aswin385-s/robotic-parallel-jaw-gripper-design/simulation_results/Simulation_Studies_Report.html

- Header
- Report Properties
- Simulation Model 1
  - Study 1 - Static Stress
    - Study Properties
    - Study Setup
      - Settings
      - Materials
      - Contacts
      - Mesh
      - Load Case1
        - Constraints
        - Loads
        - Guided Results
          - Safety Factor
        - Results
          - Safety Factor
          - Stress
          - Displacement

Study Report

Analyzed File | stress study | Version | Autodesk Fusion (2705.1.15)
Creation Date | 2026-09-25, 13:35:44 | Author | Aswin S Pillai

Report Properties

Report Properties
Title | Studies
Author | Aswin S Pillai

Simulation Model 1

Study 1 - Static Stress

Study Properties

Study Properties
Study Type | Static Stress
Last Modification Date | 2026-09-25, 12:35:28

Study Setup

Settings
General

Contact Tolerance | 0.10 mm
Remove Rigid Body Modes | No
Mesh

Average Element Size (% of model size) - Solids | 10
Scale Mesh Size Per Part | No
Average Element Size (absolute value) | -
Element Order | Parabolic
Create Curved Mesh Elements | No
Max. Turn Angle on Curves (Deg.) | 60
Max. Adjacent Mesh Size Ratio | 1.5
Max. Aspect Ratio | 10
Minimum Element Size (% of average size) | 20
Adaptive Mesh Refinement

Number of Refinement Steps | 0
Results Convergence Tolerance (%) | 20
Portion of Elements to Refine (%) | 10
Results for Baseline Accuracy | von Mises Stress

Materials
Aluminum
Components

Component | Strength
screws:1/hex_socket_cylindrical_head_M4x20(Mirror):1 | Yield Strength
screws:1/hex_socket_cylindrical_head_M4x20:1 | Yield Strength
screws:1/hex_socket_cylindrical_head_M5x08:1 | Yield Strength
screws:1/hex_socket_cylindrical_head_M5x08:2 | Yield Strength
screws:1/hex_socket_cylindrical_head_M5x08:3 | Yield Strength
screws:1/hex_socket_cylindrical_head_M5x08:4 | Yield Strength
Properties

Density | 2.700E-06 kg / mm^3
Young's Modulus | 68900.00 MPa
Poisson's Ratio | 0.33
Yield Strength | 275.00 MPa
Ultimate Tensile Strength | 310.00 MPa
Thermal Conductivity | 0.23 W / (mm K)
Thermal Expansion Coefficient | 2.360E-05 / K
Specific Heat | 897.00 J / (kg K)
Steel
Components

Component | Strength
coupler:1 | Yield Strength
pinion:1 | Yield Strength
rod 2:1 | Yield Strength
rod:1 | Yield Strength
Properties

Density | 7.850E-06 kg / mm^3
Young's Modulus | 210000.00 MPa
Poisson's Ratio | 0.30
Yield Strength | 207.00 MPa
Ultimate Tensile Strength | 345.00 MPa
Thermal Conductivity | 0.056 W / (mm K)
Thermal Expansion Coefficient | 1.200E-05 / K
Specific Heat | 480.00 J / (kg K)
Rubber, Butyl
Components

Component | Strength
jaw_pad (1):1 | Yield Strength
jaw_pad:1 | Yield Strength
Properties

Density | 1.200E-07 kg / mm^3
Young's Modulus | 2.00 MPa
Poisson's Ratio | 0.49
Yield Strength | 15.00 MPa
Ultimate Tensile Strength | 15.00 MPa
Thermal Conductivity | 8.800E-05 W / (mm K)
Thermal Expansion Coefficient | 1.300E-04 / K
Specific Heat | 1966.00 J / (kg K)
Aluminum 6061 T6 0 Cold Formed
Components

Component | Strength
arm_connection:1 | Yield Strength
gripper_base:1 | Yield Strength
jaw1:1 | Yield Strength
jaw2:1 | Yield Strength
pinion_holder:1 | Yield Strength
Properties

Density | 2.700E-06 kg / mm^3
Young's Modulus | 69000.00 MPa
Poisson's Ratio | 0.33
Yield Strength | 369.00 MPa
Ultimate Tensile Strength | 389.00 MPa
Thermal Conductivity | 0.18 W / (mm K)
Thermal Expansion Coefficient | 2.360E-05 / K
Specific Heat | 896.00 J / (kg K)

Contacts
Contact Type | Contact Set | Penetration Type | Bodies | Entities
Bonded

[M] Bonded8 | Symmetric | [Body1 rod:1||Body2 gripper_base:1] | [Face 22||Face 2185]
[M] Bonded9 | Symmetric | [Body1 rod:1||Body2 gripper_base:1] | [Face 22||Face 2184]
[M] Bonded10 | Symmetric | [Body1 rod 2:1||Body2 gripper_base:1] | [Face 22||Face 2180]
[M] Bonded11 | Symmetric | [Body1 rod 2:1||Body2 gripper_base:1] | [Face 22||Face 2181]
[M] Bonded12 | Symmetric | [Body1 pinion:1||Body1 coupler:1] | [Face 2772||Face 1855]
Bonded13 | Symmetric | [Body2 gripper_base:1||Body1 hex_socket_cylindrical_head_M4x20(Mirror):1] | [Face 2197||Face 157]
Bonded14 | Symmetric | [Body2 gripper_base:1||Body1 hex_socket_cylindrical_head_M4x20:1] | [Face 2197||Face 157]
Bonded15 | Symmetric | [Body2 gripper_base:1||Body1 rod:1] | [Face 2187||Face 24]
Bonded16 | Symmetric | [Body2 gripper_base:1||Body1 rod:1] | [Face 2186||Face 23]
Bonded17 | Symmetric | [Body2 gripper_base:1||Body1 rod 2:1] | [Face 2183||Face 24]
Bonded18 | Symmetric | [Body2 gripper_base:1||Body1 rod 2:1] | [Face 2182||Face 23]
Bonded19 | Symmetric | [Body2 gripper_base:1||Body1 hex_socket_cylindrical_head_M4x20(Mirror):1] | [Face 2156||Face 156]
Bonded20 | Symmetric | [Body2 gripper_base:1||Body1 hex_socket_cylindrical_head_M4x20(Mirror):1] | [Face 2154||Face 156]
Bonded21 | Symmetric | [Body2 gripper_base:1||Body1 hex_socket_cylindrical_head_M4x20:1] | [Face 2153||Face 156]
Bonded22 | Symmetric | [Body2 gripper_base:1||Body1 hex_socket_cylindrical_head_M4x20:1] | [Face 2151||Face 156]
Bonded23 | Symmetric | [Body2 gripper_base:1||Body1 hex_socket_cylindrical_head_M5x08:4] | [Face 2071||Face 156]
Bonded24 | Symmetric | [Body2 gripper_base:1||Body1 hex_socket_cylindrical_head_M5x08:1] | [Face 2067||Face 156]
Bonded25 | Symmetric | [Body2 gripper_base:1||Body1 hex_socket_cylindrical_head_M5x08:3] | [Face 2069||Face 156]
Bonded26 | Symmetric | [Body2 gripper_base:1||Body1 hex_socket_cylindrical_head_M5x08:2] | [Face 2065||Face 156]
Bonded28 | Symmetric | [Body1 pinion_holder:1||Body1 hex_socket_cylindrical_head_M4x20:1] | [Face 138||Face 156]
Bonded29 | Symmetric | [Body1 pinion_holder:1||Body2 gripper_base:1] | [Face 137||Face 2190]
Bonded30 | Symmetric | [Body1 pinion_holder:1||Body2 gripper_base:1] | [Face 137||Face 2160]
Bonded31 | Symmetric | [Body1 pinion_holder:1||Body2 gripper_base:1] | [Face 136||Face 2189]
Bonded32 | Symmetric | [Body1 pinion_holder:1||Body2 gripper_base:1] | [Face 136||Face 2188]
Bonded33 | Symmetric | [Body1 pinion_holder:1||Body2 gripper_base:1] | [Face 135||Face 2191]
Bonded34 | Symmetric | [Body1 pinion_holder:1||Body2 gripper_base:1] | [Face 135||Face 2162]
Bonded35 | Symmetric | [Body1 pinion_holder:1||Body2 gripper_base:1] | [Face 134||Face 2161]
Bonded36 | Symmetric | [Body1 pinion_holder:1||Body2 gripper_base:1] | [Face 134||Face 2159]
Bonded37 | Symmetric | [Body1 pinion_holder:1||Body1 hex_socket_cylindrical_head_M4x20(Mirror):1] | [Face 131||Face 156]
Bonded38 | Symmetric | [Body1 jaw2:1||Body2 gripper_base:1] | [Face 2099||Face 2196]
Bonded39 | Symmetric | [Body1 jaw2:1||Body1 jaw_pad (1):1] | [Face 2097||Face 385]
Bonded40 | Symmetric | [Body1 jaw2:1||Body1 hex_socket_cylindrical_head_M4x20:1] | [Face 2090||Face 158]
Bonded41 | Symmetric | [Body1 jaw2:1||Body1 pinion_holder:1] | [Face 2089||Face 134]
Bonded42 | Symmetric | [Body1 jaw2:1||Body1 pinion_holder:1] | [Face 2088||Face 135]
Bonded43 | Symmetric | [Body1 jaw1:1||Body2 gripper_base:1] | [Face 2085||Face 2196]
Bonded44 | Symmetric | [Body1 jaw1:1||Body1 jaw_pad:1] | [Face 2079||Face 368]
Bonded45 | Symmetric | [Body1 jaw1:1||Body1 pinion_holder:1] | [Face 2077||Face 137]
Bonded46 | Symmetric | [Body1 jaw1:1||Body1 pinion_holder:1] | [Face 2076||Face 134]
Bonded47 | Symmetric | [Body1 pinion:1||Body1 coupler:1] | [Face 2916||Face 1847]
Bonded48 | Symmetric | [Body1 pinion:1||Body1 pinion_holder:1] | [Face 2768||Face 130]
[M] Bonded49 | Symmetric | [Body2 gripper_base:1||Body4 arm_connection:1] | [Face 2062||Face 494]
Bonded50 | Symmetric | [Body4 arm_connection:1||Body1 hex_socket_cylindrical_head_M5x08:2] | [Face 521||Face 157]
Bonded51 | Symmetric | [Body4 arm_connection:1||Body1 hex_socket_cylindrical_head_M5x08:4] | [Face 492||Face 156]
Bonded52 | Symmetric | [Body4 arm_connection:1||Body1 hex_socket_cylindrical_head_M5x08:3] | [Face 491||Face 156]
Bonded53 | Symmetric | [Body4 arm_connection:1||Body1 hex_socket_cylindrical_head_M5x08:1] | [Face 490||Face 156]
Bonded54 | Symmetric | [Body4 arm_connection:1||Body1 hex_socket_cylindrical_head_M5x08:2] | [Face 489||Face 156]
Sliding

[M] Sliding4 | Symmetric | [Body1 jaw1:1||Body1 rod:1] | [Face 2075||Face 22]
[M] Sliding5 | Symmetric | [Body1 jaw1:1||Body1 rod 2:1] | [Face 2074||Face 22]
[M] Sliding6 | Symmetric | [Body1 jaw2:1||Body1 rod 2:1] | [Face 2086||Face 22]
[M] Sliding7 | Symmetric | [Body1 jaw2:1||Body1 rod:1] | [Face 2087||Face 22]
Separation

[M] Separation2 | Symmetric | [Body1 pinion:1||Body1 jaw2:1] | [Face 2912||Face 2137]
[M] Separation3 | Symmetric | [Body1 pinion:1||Body1 jaw1:1] | [Face 2882||Face 2165]

Mesh
Type | Solids
Nodes | 526544
Elements | 332937

Load Case1

Constraints
Fixed3

Type | Fixed
Ux | Fixed
Uy | Fixed
Uz | Fixed

Loads
Gravity

Type | Gravity
Magnitude | 9.807 m / s^2
X Value | 0.00 m / s^2
Y Value | 0.00 m / s^2
Z Value | -9.807 m / s^2
Force1

Type | Force
Magnitude | 120.00 N
X Value | -120.00 N
Y Value | 0.00 N
Z Value | 0.00 N
Flip Direction | Yes
Force Per Entity | No
Force2

Type | Force
Magnitude | 120.00 N
X Value | 120.00 N
Y Value | 0.00 N
Z Value | 0.00 N
Flip Direction | Yes
Force Per Entity | No

Load Case1 - Guided Results

Safety Factor

With the analysis criteria in this study setup, the design is expected to bend permanently or break.

Next Steps

Below Safety Factor Target

Validate your study setup

Check the loads are not set too high

Check the mesh refinement and consider increasing it in areas of high stress

Confirm your Safety Factor requirement

If the Displacement result shows high displacement, consider running a Nonlinear study to gain more insight

Check other results

Examine the Below target Result visualization to see where the weakest areas are

Check the stress result to see if, and where, the material might yield

Check the displacement result to see how far from its original alignment the model has moved

Look at other results, such as reaction forces to check your study set up, or strain to check your material performance

Strengthen weak areas

Add more material to weak areas

Select a material with a higher yield strength

Stiffen the design

Modify the shape with a Generative Design study

Generate alternative designs

Add more material to weak areas

Select a material with a higher yield strength

Stiffen the design

Modify the shape with a Generative Design study

Above Safety Factor Limit

Validate your study setup

Check the loads are not set too high

Check the mesh refinement and consider increasing it in areas of high stress

Confirm your Safety Factor requirement

If the Displacement result shows high displacement, consider running a Nonlinear study to gain more insight

Check other results

Examine the Below target Result visualization to see where the weakest areas are

Check the stress result to see if, and where, the material might yield

Check the displacement result to see how far from its original alignment the model has moved

Look at other results, such as reaction forces to check your study set up, or strain to check your material performance

Lightweight the design

Set a Safety Factor upper limit to find where material can be removed

Remove material from areas that exceed the Safety Factor upper limit

Generate alternative designs

In the Generative Design workspace, create design modifications

Remove unnecessary material using a Shape Optimization study

Load Case1 - Results

Result Summary
Result type | Sub-result | Minimum | Maximum

Safety Factor

Safety Factor

Stress

Von Mises

$$ImageCompatibilityInfo$

1st Principal

$$ImageCompatibilityInfo$

3rd Principal

$$ImageCompatibilityInfo$

Displacement

Total
