aswin385-s/robotic-parallel-jaw-gripper-design/cad_files/complete_gripper_assembly.step

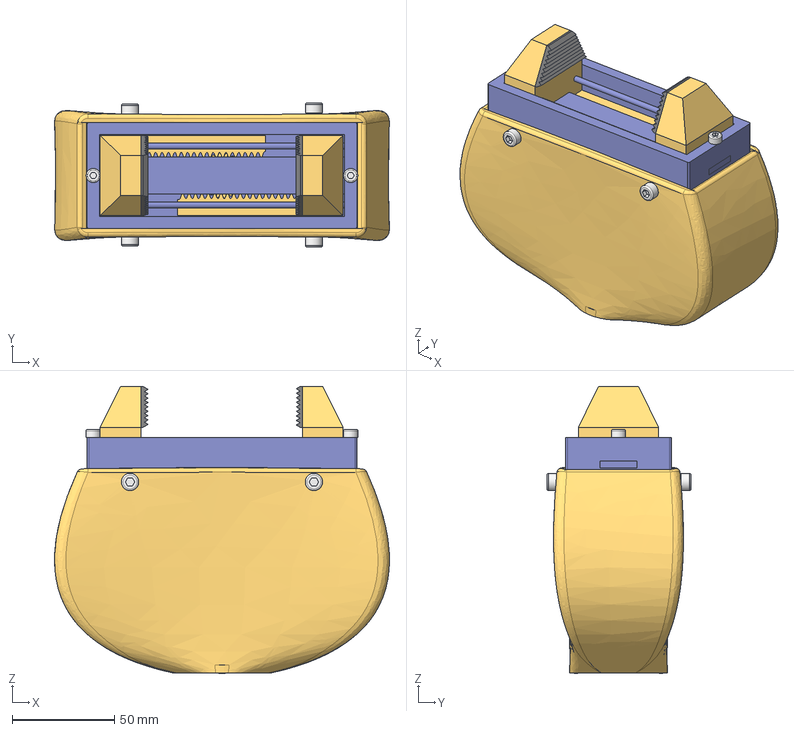
[picture p22: CAD file, 2026-10-18]
cad_files/complete_gripper_assembly.step
164.0 x 70.5 x 140.5 mm
REV Robotics-REV-41-1558
DS Servo DS5160 SSG
VITE_TESTA_CILINDRICA_ALTA_ESAGONO_INCASSATO x 4
VITE_TESTA_CILINDRICA_ALTA_ESAGONO_INCASSATO_1
VITE_TESTA_CILINDRICA_ALTA_ESAGONO_INCASSATO_2
VITE_TESTA_CILINDRICA_ALTA_ESAGONO_INCASSATO_3 x 4
