aswin385-s/robotic-parallel-jaw-gripper-design/cad_files/rod 2.step

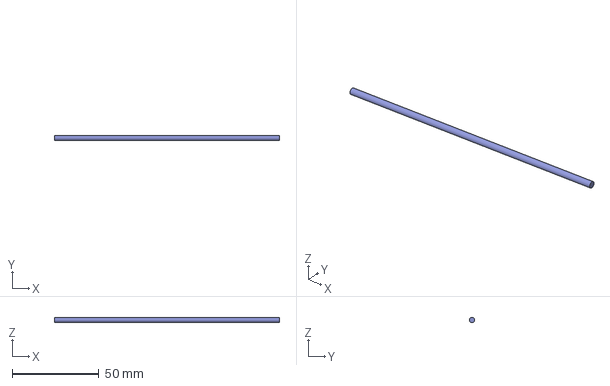
[picture p23: CAD file, 2026-10-18]
cad_files/rod 2.step
130.0 x 3.00 x 3.00 mm
