aswin385-s/robotic-parallel-jaw-gripper-design/cad_files/coupler.step

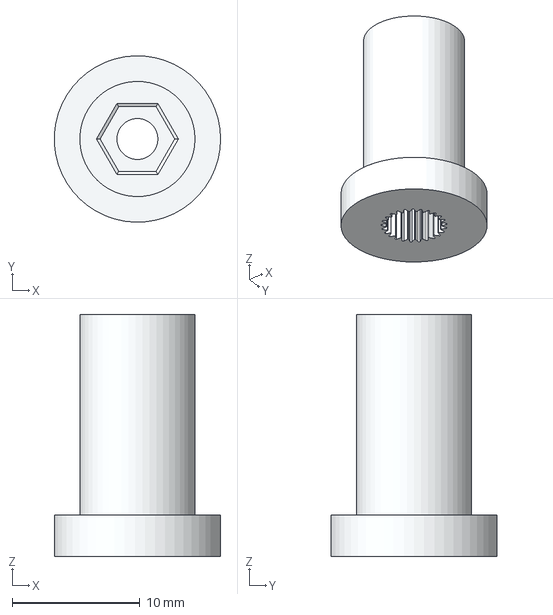
[picture p24: CAD file, 2026-10-18]
cad_files/coupler.step
13.0 x 13.0 x 18.9 mm
