aswin385-s/robotic-parallel-jaw-gripper-design/cad_files/jaw2.step

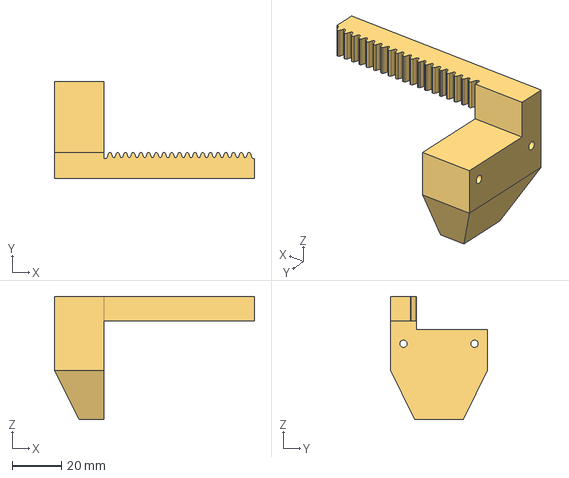
[picture p25: CAD file, 2026-10-18]
cad_files/jaw2.step
81.0 x 39.3 x 50.0 mm
