aswin385-s/robotic-parallel-jaw-gripper-design/cad_files/hex_socket_cylindrical_head_M4x20.step

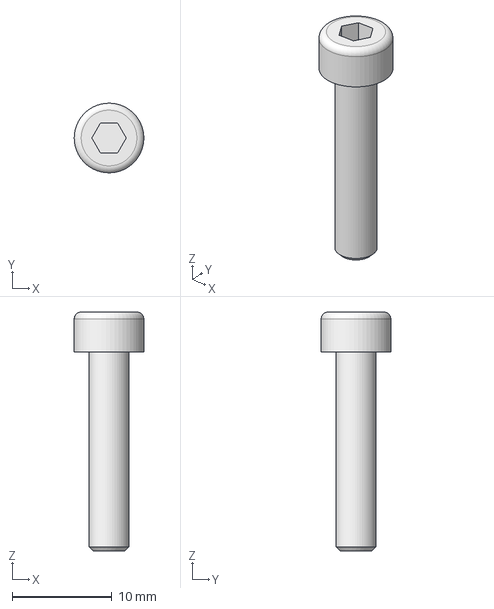
[picture p26: CAD file, 2026-10-18]
cad_files/hex_socket_cylindrical_head_M4x20.step
6.99 x 7.00 x 24.0 mm
