aswin385-s/robotic-parallel-jaw-gripper-design/cad_files/pinion.step

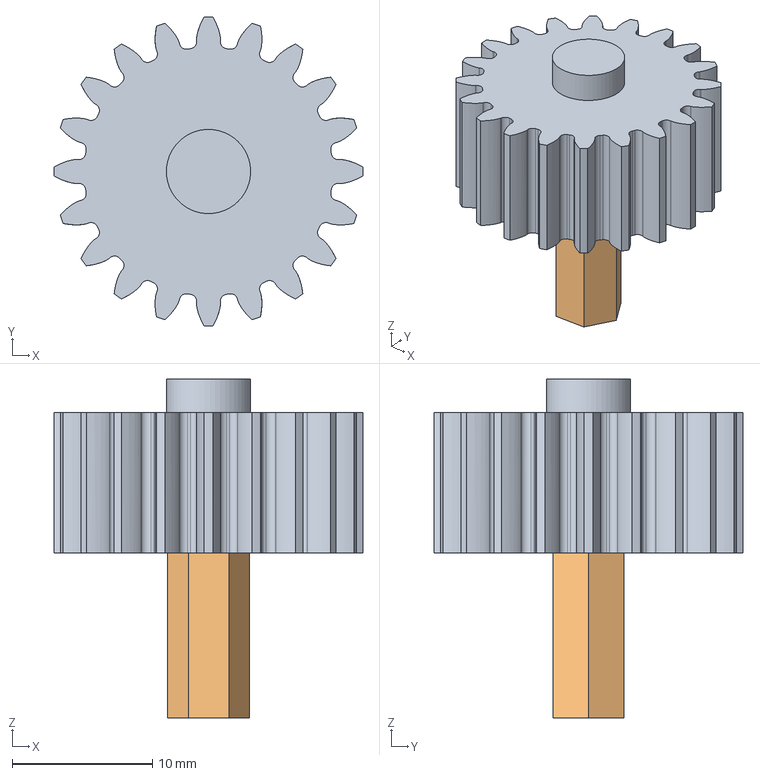
[picture p27: CAD file, 2026-10-18]
cad_files/pinion.step
22.0 x 22.0 x 24.1 mm
