aswin385-s/robotic-parallel-jaw-gripper-design/cad_files/DS Servo DS5160 SSG.step

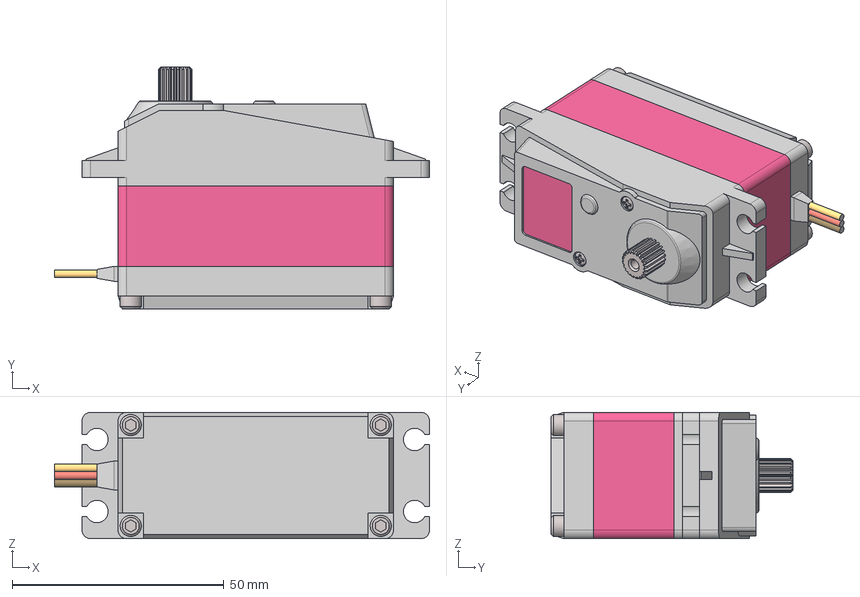
[picture p28: CAD file, 2026-10-18]
cad_files/DS Servo DS5160 SSG.step
88.5 x 57.0 x 29.8 mm
