aswin385-s/robotic-parallel-jaw-gripper-design/cad_files/arm_connection.step

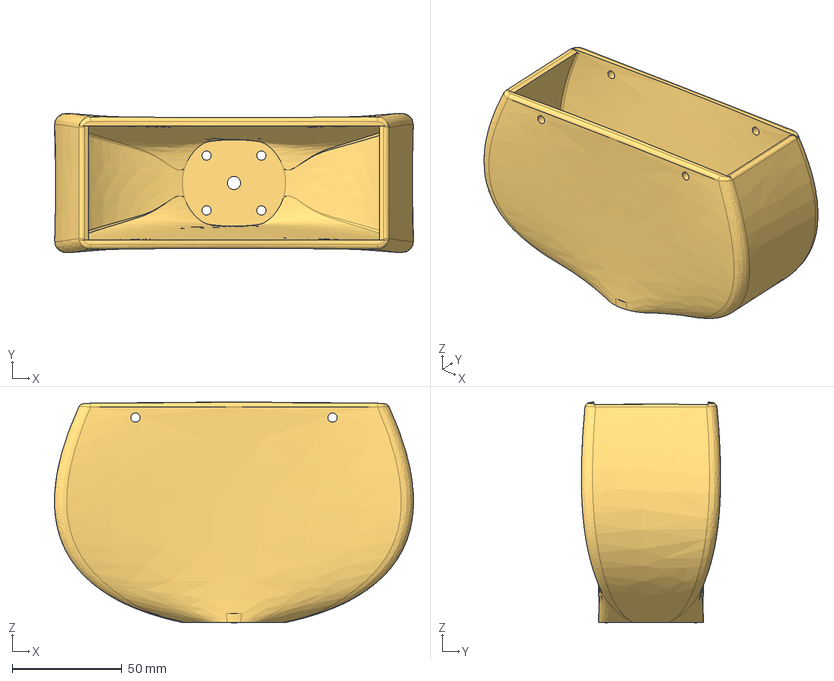
[picture p30: CAD file, 2026-10-18]
cad_files/arm_connection.step
163.9 x 63.6 x 100.9 mm
