aswin385-s/robotic-parallel-jaw-gripper-design/cad_files/pinion_holder.step

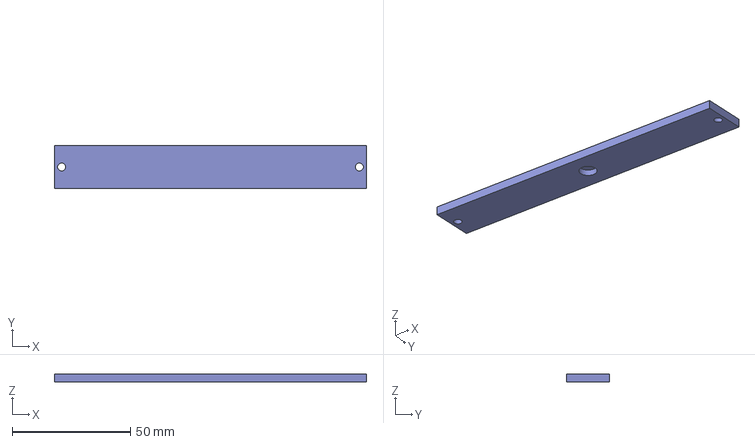
[picture p31: CAD file, 2026-10-18]
cad_files/pinion_holder.step
132.0 x 18.2 x 3.40 mm
