aswin385-s/robotic-parallel-jaw-gripper-design/cad_files/jaw_pad 2.step

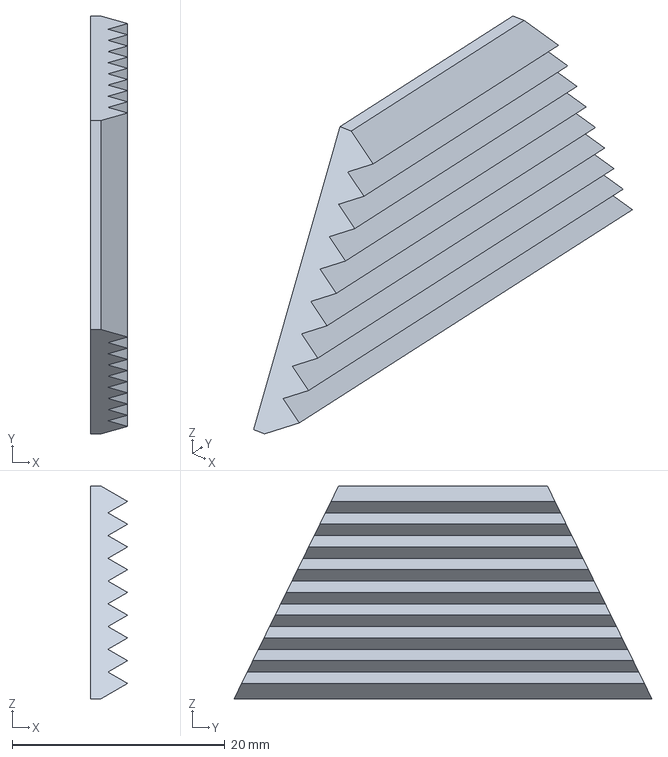
[picture p32: CAD file, 2026-10-18]
cad_files/jaw_pad 2.step
3.50 x 39.3 x 20.0 mm
