aswin385-s/robotic-parallel-jaw-gripper-design/cad_files/hex_socket_cylindrical_head_M5x16.step

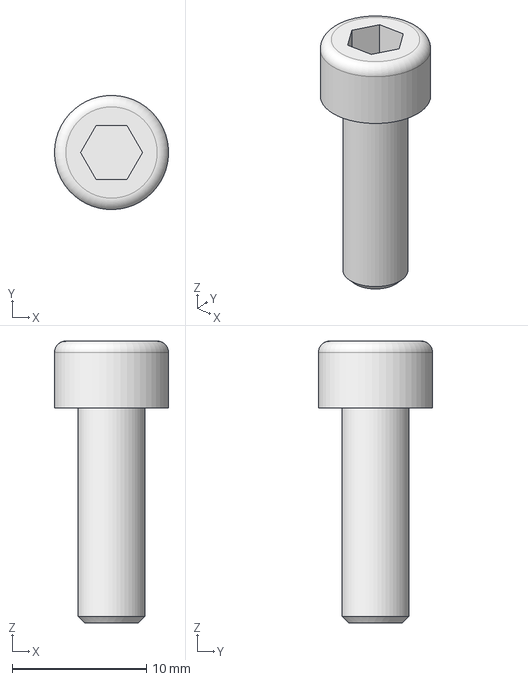
[picture p33: CAD file, 2026-10-18]
cad_files/hex_socket_cylindrical_head_M5x16.step
8.49 x 8.50 x 21.0 mm
