aswin385-s/robotic-parallel-jaw-gripper-design/cad_files/jaw_pad.step

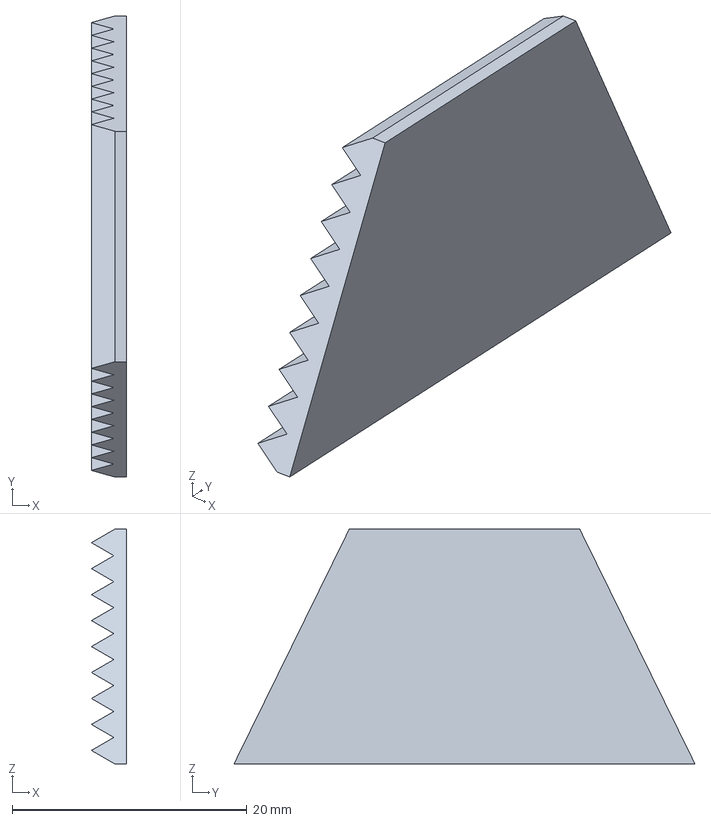
[picture p34: CAD file, 2026-10-18]
cad_files/jaw_pad.step
3.00 x 39.3 x 20.0 mm
