aswin385-s/robotic-parallel-jaw-gripper-design/cad_files/gripper_base.step

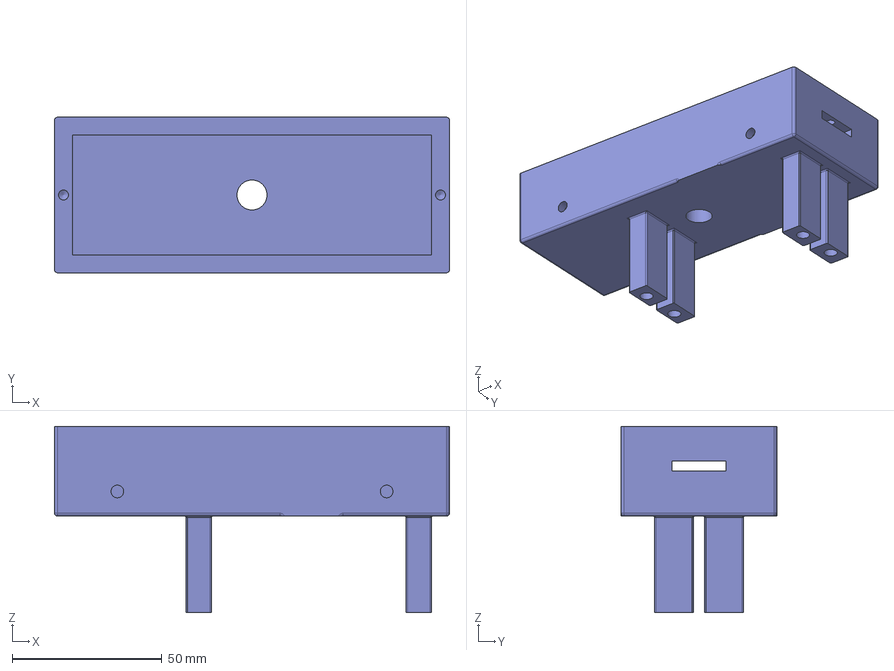
[picture p35: CAD file, 2026-10-18]
cad_files/gripper_base.step
132.0 x 52.0 x 62.2 mm
