aswin385-s/robotic-parallel-jaw-gripper-design/(list of files, cad)

Other CAD files:
cad_files/rod.step
cad_files/jaw1.step
