aswin385-s/robotic-parallel-jaw-gripper-design/simulation_results/Applied_Force_120N_Jaw2.png

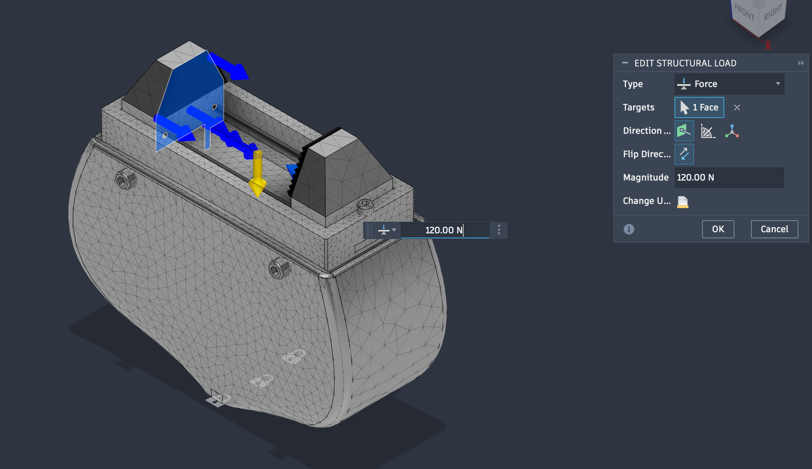
simulation_results/Applied_Force_120N_Jaw2.png
