aswin385-s/robotic-parallel-jaw-gripper-design/simulation_results/Boundary_Condition_Fixed.png

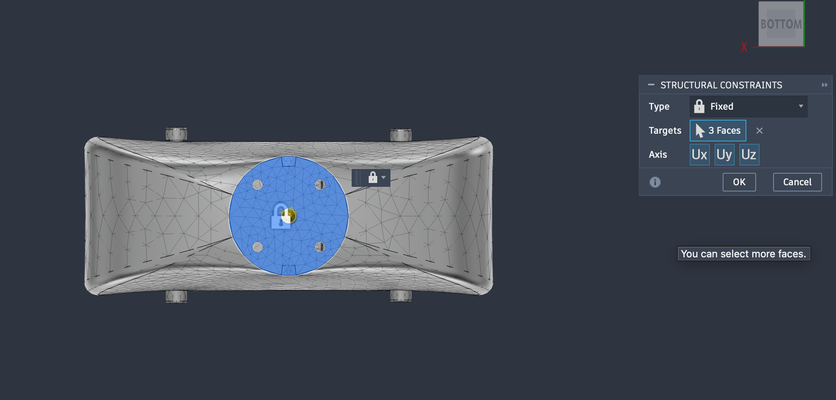
simulation_results/Boundary_Condition_Fixed.png
