aswin385-s/robotic-parallel-jaw-gripper-design/simulation_results/Gravity_9.807ms2.png

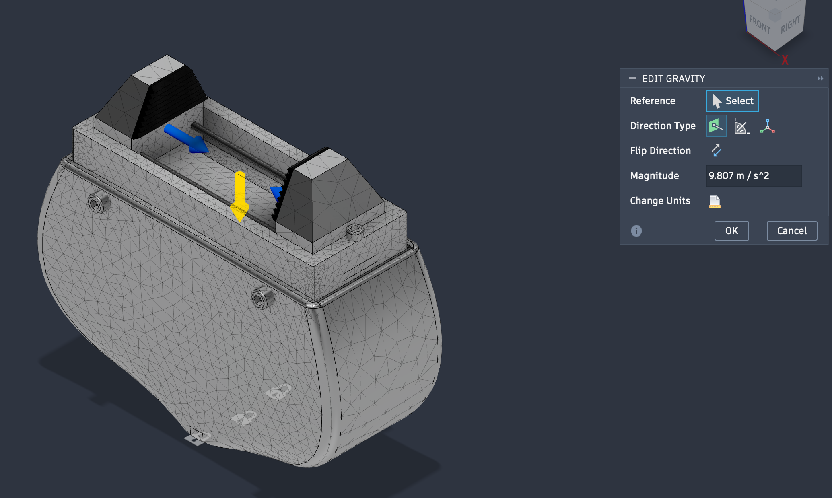
simulation_results/Gravity_9.807ms2.png
